MakersAsylumIndia/DevCon8_RGB_Wall/README.md

# MAKER'S ASYLUM
## DevCon8 2026 MUMBAI
## RGB INTERACTIVE WALL

One ESP32, One RGB Ring LED, One touch sensor, and much WOW !!!!
A large, interactive LED wall installation using super simple hardware. Touching one touch should (hopefully) propogate ligh ripples across the wall.

## License

Licenses

<a href="LICENSE.md">Open Source Licenses Facts</a>

#### Hardware
CERN Open Hardware License Version 2 - Strongly Reciprocal ([CERN-OHL-S-2.0](https://spdx.org/licenses/CERN-OHL-S-2.0.html)).

#### Software
MIT open source [license](http://opensource.org/licenses/MIT).

#### Documentation:
<br />This work is licensed under a <a rel="license" href="http://creativecommons.org/licenses/by/4.0/">Creative Commons Attribution 4.0 International License</a>.

---

## 📬 Contact/Team

> _List team members and contact emails or GitHub profiles._
[@anool](https://github.com/Anool)
> 
>
> ---
