MakersAsylumIndia/DevCon8_RGB_Wall/Electronics/README.md

https://app.cirkitdesigner.com/project/69f61cf8-2887-4394-9dc5-f0c2b9237c84

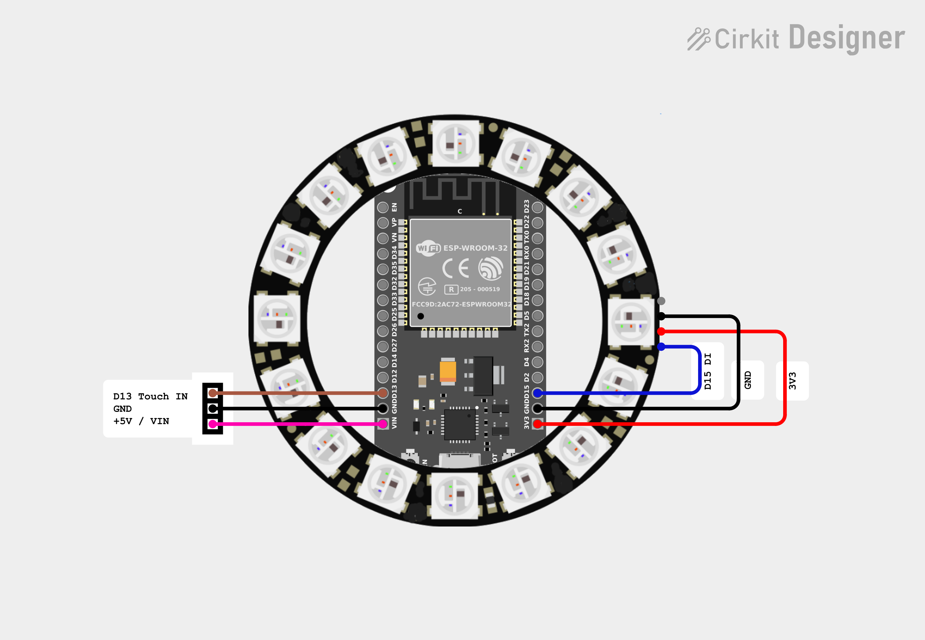
[picture p1: Electronics/circuit_image.png]
Circuit Diagram
</a>
