MakersAsylumIndia/DevCon8_RGB_Wall/Documentation/MA Slides Template.pdf

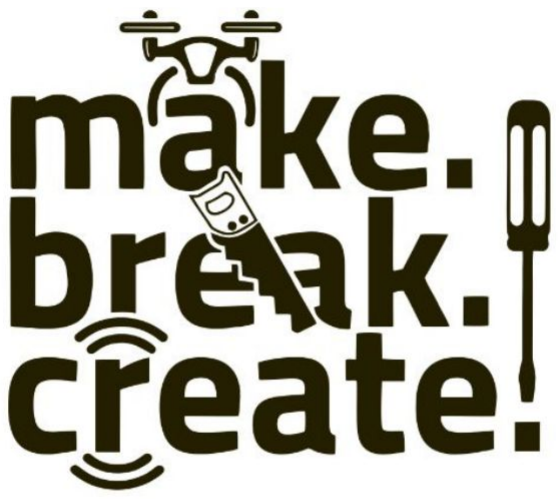
[picture p21: figure]
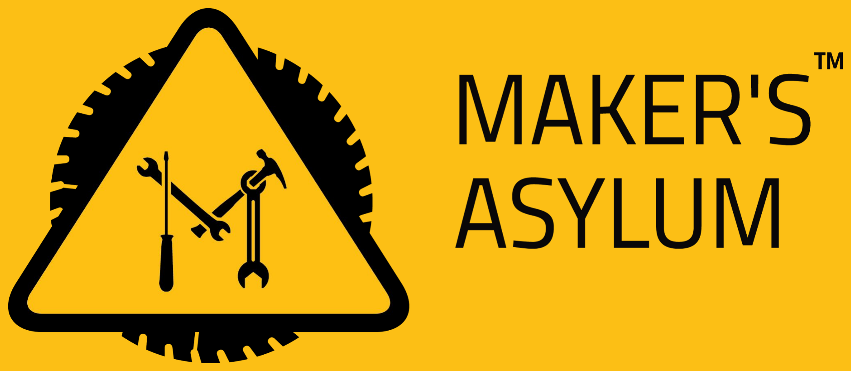
[picture p22: figure]
