MakersAsylumIndia/DevCon8_RGB_Wall/CAD/assets/jst-xh-2-5-connector-family-1.snapshot.31/XH_show.png

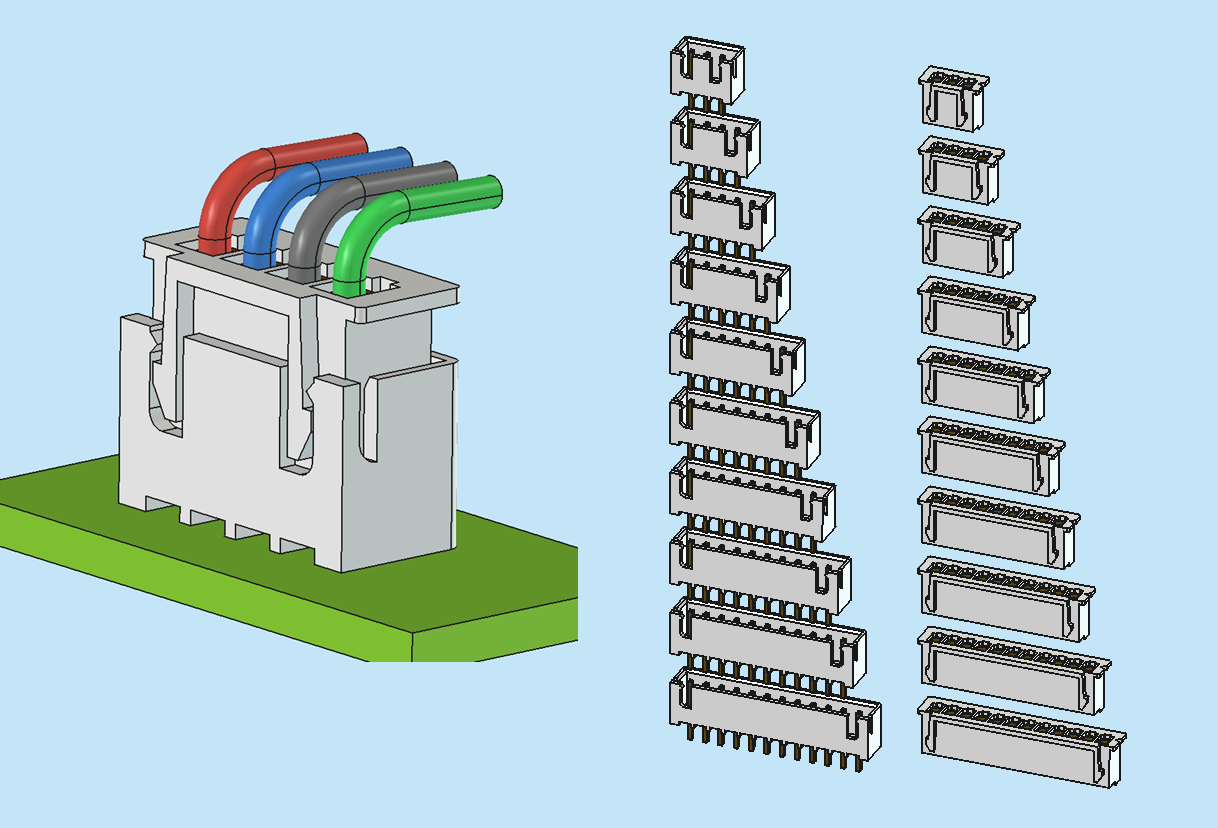
CAD/assets/jst-xh-2-5-connector-family-1.snapshot.31/XH_show.png
