MakersAsylumIndia/DevCon8_RGB_Wall/Documentation/1199px-voyager_instruments_2x.png

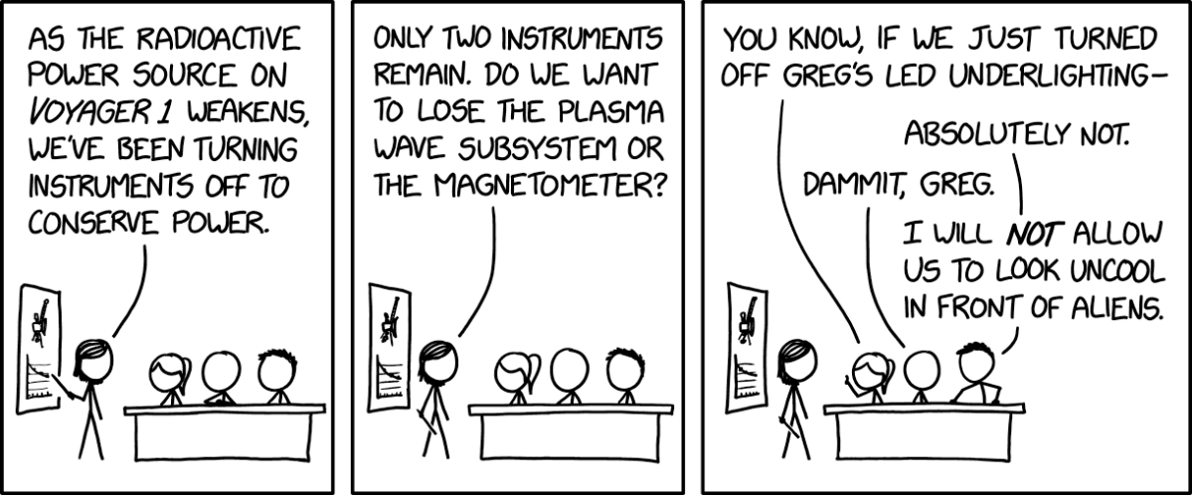
Documentation/1199px-voyager_instruments_2x.png
