MakersAsylumIndia/DevCon8_RGB_Wall/Photos_Videos/Images/WhatsApp Image 2026-11-02 at 15.57.53.jpeg

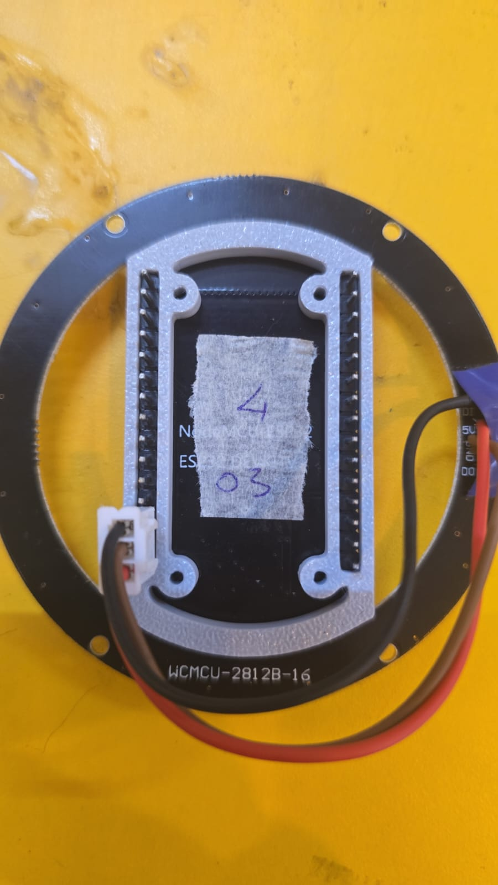
Photos_Videos/Images/WhatsApp Image 2026-11-02 at 15.57.53.jpeg
