MakersAsylumIndia/DevCon8_RGB_Wall/Photos_Videos/Images/WhatsApp Image 2026-11-02 at 16.00.12.jpeg

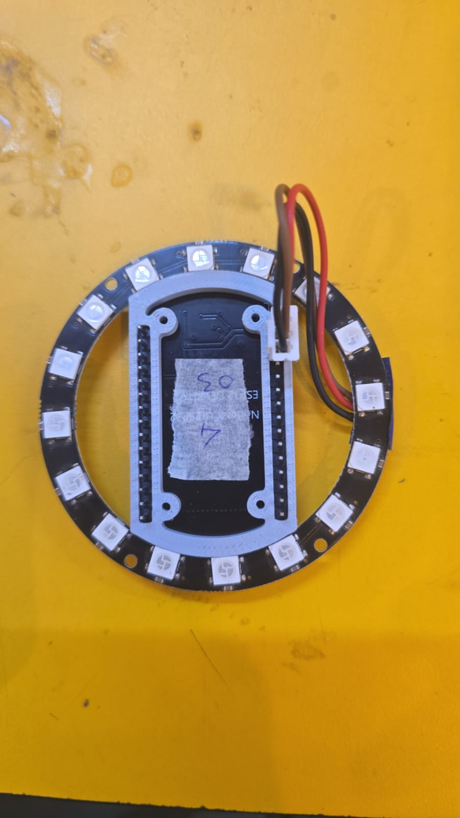
Photos_Videos/Images/WhatsApp Image 2026-11-02 at 16.00.12.jpeg
