MakersAsylumIndia/DevCon8_RGB_Wall/Photos_Videos/Images/WhatsApp Image 2026-11-02 at 17.14.00.jpeg

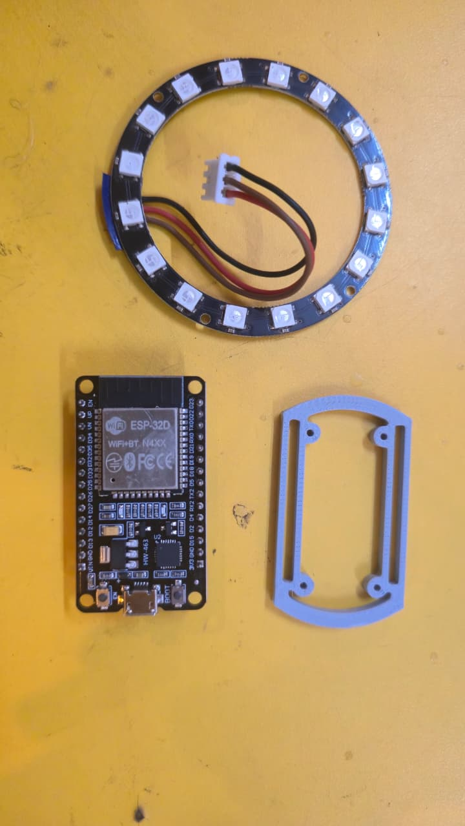
Photos_Videos/Images/WhatsApp Image 2026-11-02 at 17.14.00.jpeg
