MakersAsylumIndia/DevCon8_RGB_Wall/CAD/assets/ESP32_DevKitV1/ESP32_DevKitV1.FCStd

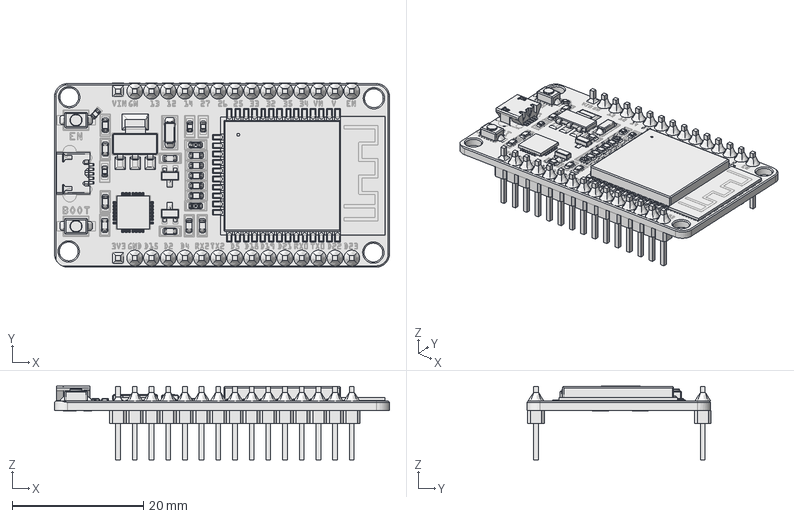
[picture p35: CAD file, 2026-10-30]
CAD/assets/ESP32_DevKitV1/ESP32_DevKitV1.FCStd
51.0 x 28.0 x 11.2 mm
