MakersAsylumIndia/DevCon8_RGB_Wall/CAD/assets/jst-xh-2-5-connector-family-1.snapshot.31/XH_top_entry+housing.FCStd

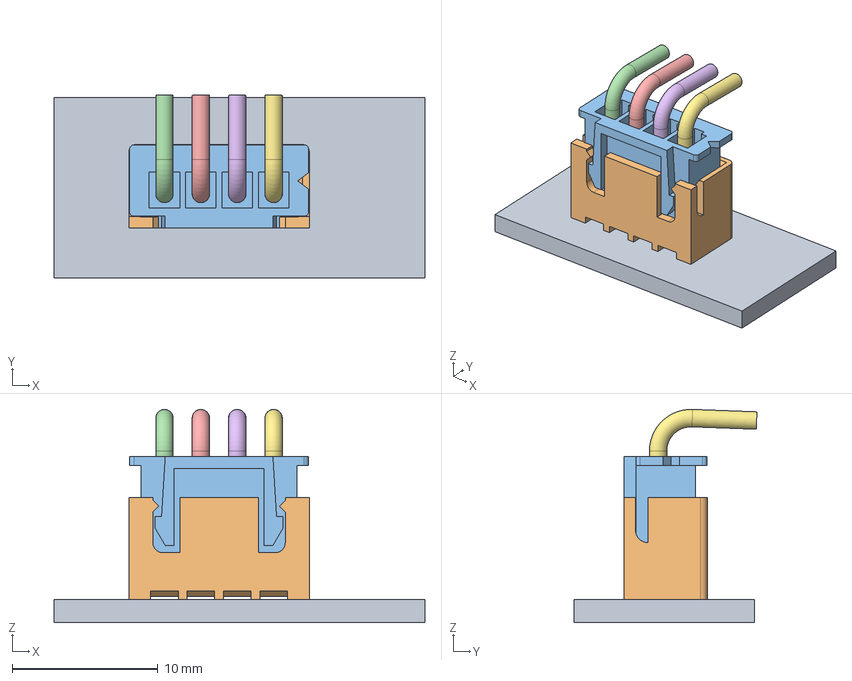
[picture p37: CAD file, 2026-10-30]
CAD/assets/jst-xh-2-5-connector-family-1.snapshot.31/XH_top_entry+housing.FCStd
25.5 x 12.6 x 14.6 mm
PCB_example
Top_entry_base
Housing
red_wire
blue_wire
black_wire
green_wire
