MakersAsylumIndia/DevCon8_RGB_Wall/CAD/assets/NeoPixelRing16.step

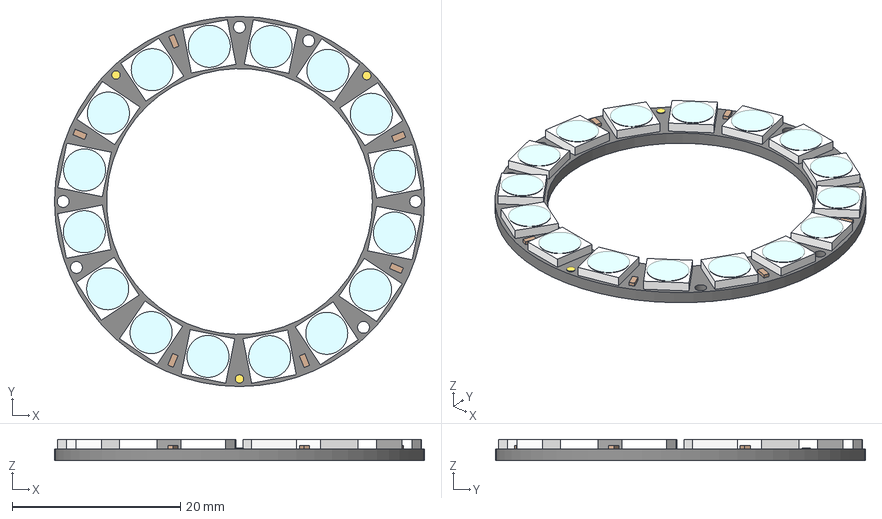
[picture p39: CAD file, 2026-10-30]
CAD/assets/NeoPixelRing16.step
44.0 x 44.0 x 2.55 mm
