MakersAsylumIndia/DevCon8_RGB_Wall/CAD/Hex_Node_02.FCStd

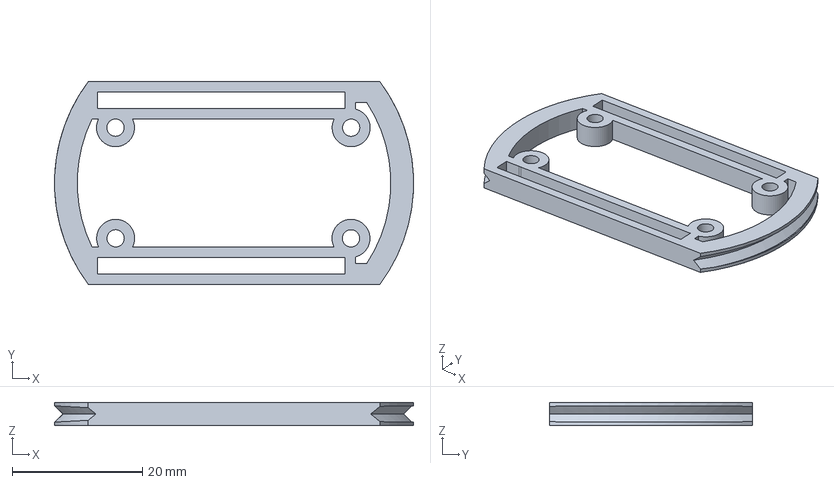
[picture p40: CAD file, 2026-11-03]
CAD/Hex_Node_02.FCStd
55.2 x 31.2 x 3.60 mm
