MakersAsylumIndia/DevCon8_RGB_Wall/CAD/assets/jst-xh-2-5-connector-family-1.snapshot.31/XH_housing_V_steps/XH_housing_9P.step

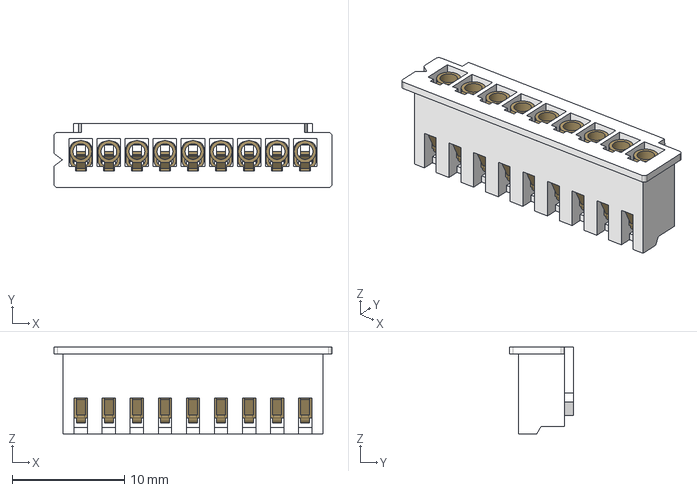
[picture p41: CAD file, 2026-10-30]
CAD/assets/jst-xh-2-5-connector-family-1.snapshot.31/XH_housing_V_steps/XH_housing_9P.step
24.8 x 5.70 x 7.75 mm
Housing
modele_pin x 9
