MakersAsylumIndia/DevCon8_RGB_Wall/CAD/assets/jst-xh-2-5-connector-family-1.snapshot.31/XH_top_entry_steps/XH_top_entry_3P.step

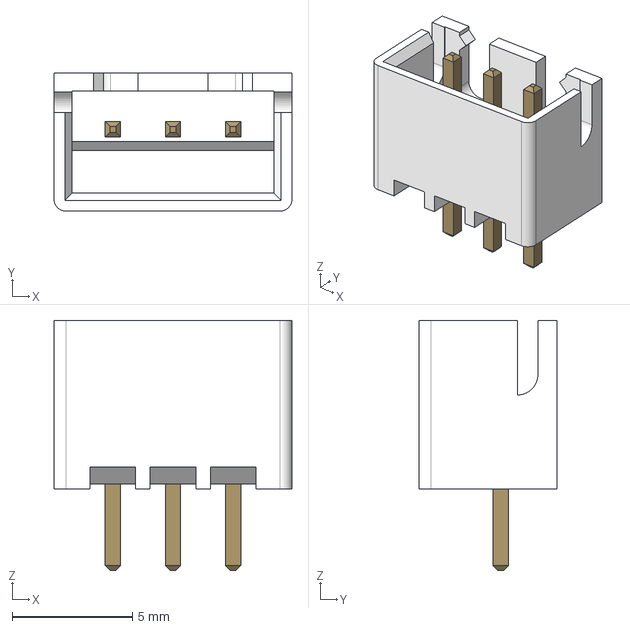
[picture p42: CAD file, 2026-10-30]
CAD/assets/jst-xh-2-5-connector-family-1.snapshot.31/XH_top_entry_steps/XH_top_entry_3P.step
9.90 x 5.75 x 10.4 mm
Top_entry_base
Pin x 3
