MakersAsylumIndia/DevCon8_RGB_Wall/CAD/assets/USB Male.step

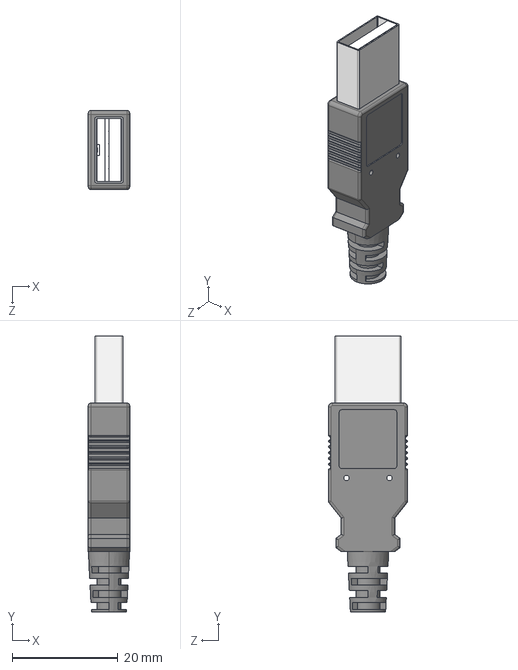
[picture p43: CAD file, 2026-10-30]
CAD/assets/USB Male.step
7.87 x 52.3 x 15.0 mm
