MakersAsylumIndia/DevCon8_RGB_Wall/CAD/assets/JR-3_with_cable.step

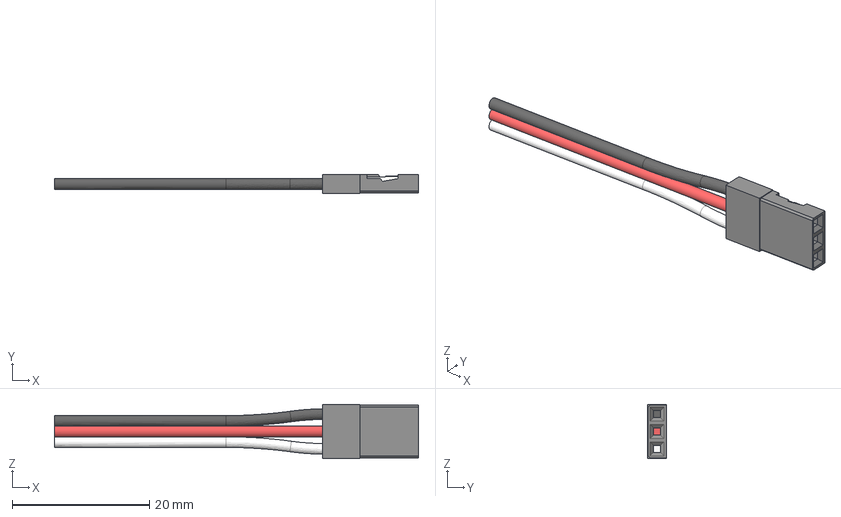
[picture p44: CAD file, 2026-10-30]
CAD/assets/JR-3_with_cable.step
53.0 x 2.75 x 7.90 mm
JR-3
JWT-CONTACT x 3
Cable_JR
