MakersAsylumIndia/DevCon8_RGB_Wall/CAD/Hex_Node_01.FCStd

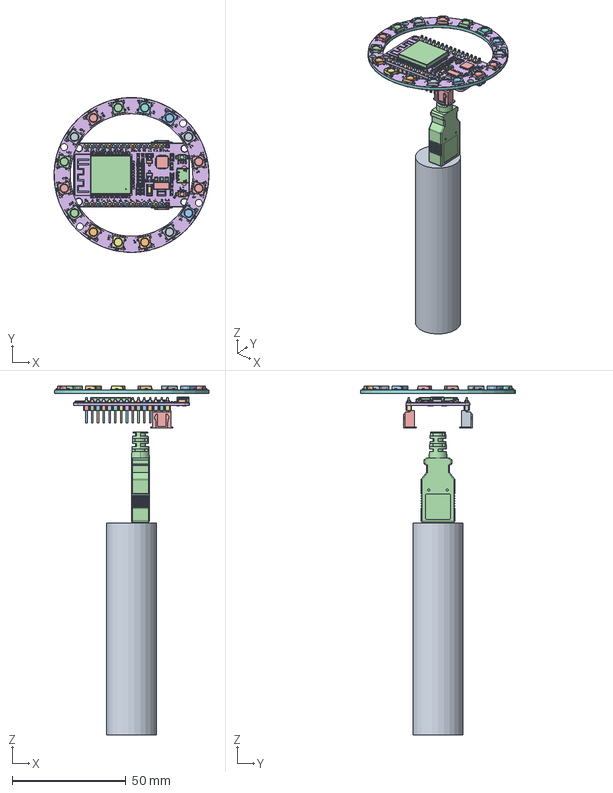
[picture p49: CAD file, 2026-10-30]
CAD/Hex_Node_01.FCStd
68.0 x 68.0 x 153.2 mm
ESP32_DevKitV1
ESP32_DevKitV001
ESP32_DevKitV002
ESP32_DevKitV003
ESP32_DevKitV004
ESP32_DevKitV005
ESP32_DevKitV006
ESP32_DevKitV007
ESP32_DevKitV008
ESP32_DevKitV009
ESP32_DevKitV010
ESP32_DevKitV011
ESP32_DevKitV012
ESP32_DevKitV013
ESP32_DevKitV014
ESP32_DevKitV015
ESP32_DevKitV016
ESP32_DevKitV017
ESP32_DevKitV018
ESP32_DevKitV019
ESP32_DevKitV020
ESP32_DevKitV021
ESP32_DevKitV022
ESP32_DevKitV023
ESP32_DevKitV024
ESP32_DevKitV025
ESP32_DevKitV026
ESP32_DevKitV027
ESP32_DevKitV028
ESP32_DevKitV029
ESP32_DevKitV030
ESP32_DevKitV031
ESP32_DevKitV032
ESP32_DevKitV033
ESP32_DevKitV034
ESP32_DevKitV035
ESP32_DevKitV036
ESP32_DevKitV037
ESP32_DevKitV038
ESP32_DevKitV039
ESP32_DevKitV040
ESP32_DevKitV041
ESP32_DevKitV042
ESP32_DevKitV043
ESP32_DevKitV044
ESP32_DevKitV045
ESP32_DevKitV046
ESP32_DevKitV047
ESP32_DevKitV048
ESP32_DevKitV049
ESP32_DevKitV050
ESP32_DevKitV051
ESP32_DevKitV052
ESP32_DevKitV053
ESP32_DevKitV054
ESP32_DevKitV055
ESP32_DevKitV056
ESP32_DevKitV057
ESP32_DevKitV058
ESP32_DevKitV059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
