MakersAsylumIndia/DevCon8_RGB_Wall/(list of files, cad)

Other CAD files:
CAD/Hex_Node_02-Hex_Node_holder.step
CAD/Hex_Node_02-Hex_Node_holder.gcode.3mf
CAD/Hex_Node_02-Hex_Node_holder.3mf
CAD/Hex_Node_02-Hex_Node_holder.stl
CAD/assets/ESP32_DevKitV1/ESP32_DevKitV1.dwg
