MakersAsylumIndia/DevCon8_RGB_Wall/Code/HexNode_01/secrets.example.h

// Copy this file to secrets.h (same folder) and fill in your 2.4 GHz Wi-Fi.
// secrets.h is gitignored: never commit real credentials.
#pragma once
#define WIFI_SSID  "PUT_VENUE_WIFI_NAME_HERE"
#define WIFI_PASS  "PUT_VENUE_WIFI_PASSWORD_HERE"   // "" for an open network
