MakersAsylumIndia/DevCon8_RGB_Wall/(commit log)

2026-10-31 Update README with project link and circuit image
    Added a link to the circuit designer project and included an image of the circuit diagram.
2026-10-31 circuit diagrams
2026-11-03 added slide deck
    [Hex_Node_02-Hex_Node_holder.3mf, Hex_Node_02-Hex_Node_holder.gcode.3mf, Hex_Node_02-Hex_Node_holder.step, Hex_Node_02-Hex_Node_holder.stl, Hex_Node_02.FCStd]
2026-11-05 Add bulk flashing, touch test and over-the-air update tools
    - flash_fast.sh: compile once, flash many boards in parallel via esptool
    - hexnode.sh + hexnode_serial.py: per-board flash with D13 touch test,
    ring check and Ethereum logo positions
    - wifi_check.sh + WifiCheck sketch: test venue Wi-Fi (join, captive
    portal, client isolation, channel)
    - wall_net.h, ota_server.py, ota_release.sh: Wi-Fi + pull-based OTA with
    a 15-download queue, test batch before full release, status page
    - HexNode_01: fix NeoPixel crash on esp32 core 3.x, one ripple per touch,
    onboard LED + ring glow while touched, ring self-test at boot
    - secrets.h stays gitignored; secrets.example.h shows the format
    Co-Aut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
    [ethereum_layout.csv]
2026-11-05 Add Windows version of flash_fast (flash_fast.bat + flash_fast.ps1)
    Double-click flash_fast.bat; it runs flash_fast.ps1 with the same flow as
    flash_fast.sh: compile once (or use a prebuilt firmware\ folder), flash
    every plugged-in board in parallel, 460800 baud with a 115200 retry,
    3 s unplug debounce, sounds and flash_fast_log.csv. Finds boards by USB
    chip name (CP210x/CH340/...), so built-in COM1 is skipped. Written for
    Windows PowerShell 5.1; not yet run on a Windows machine.
2026-11-06 Firmware v9: Wi-Fi retry, white mode and remote commands
    - wall_net.h: a board that can't join at power-on retries the Wi-Fi every
    60 s instead of staying offline until its next power cycle; Wi-Fi setup
    (power save off, tx power, UDP socket) re-runs on every (re)join
    - Remote commands over UDP ("HEXCMD <id|all> <cmd>"): blink, ring, test
    (ripple), white, normal. Only these are accepted; boards report how
    many they ran (cmds=) so the server can confirm delivery
    - White mode (default on, saved in flash): steady white base instead of
    the colour glow; ripples and touch glow still show on top
    - ota_server.py: POST /api/cmd plus buttons on the status page (shown
    once the release is v9+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
